zycero/AiPocket-Kicad-ESP32-P4-seconde/AI_Pocket.kicad_pcb

## KiCad design AI_Pocket.kicad_pcb (continued)

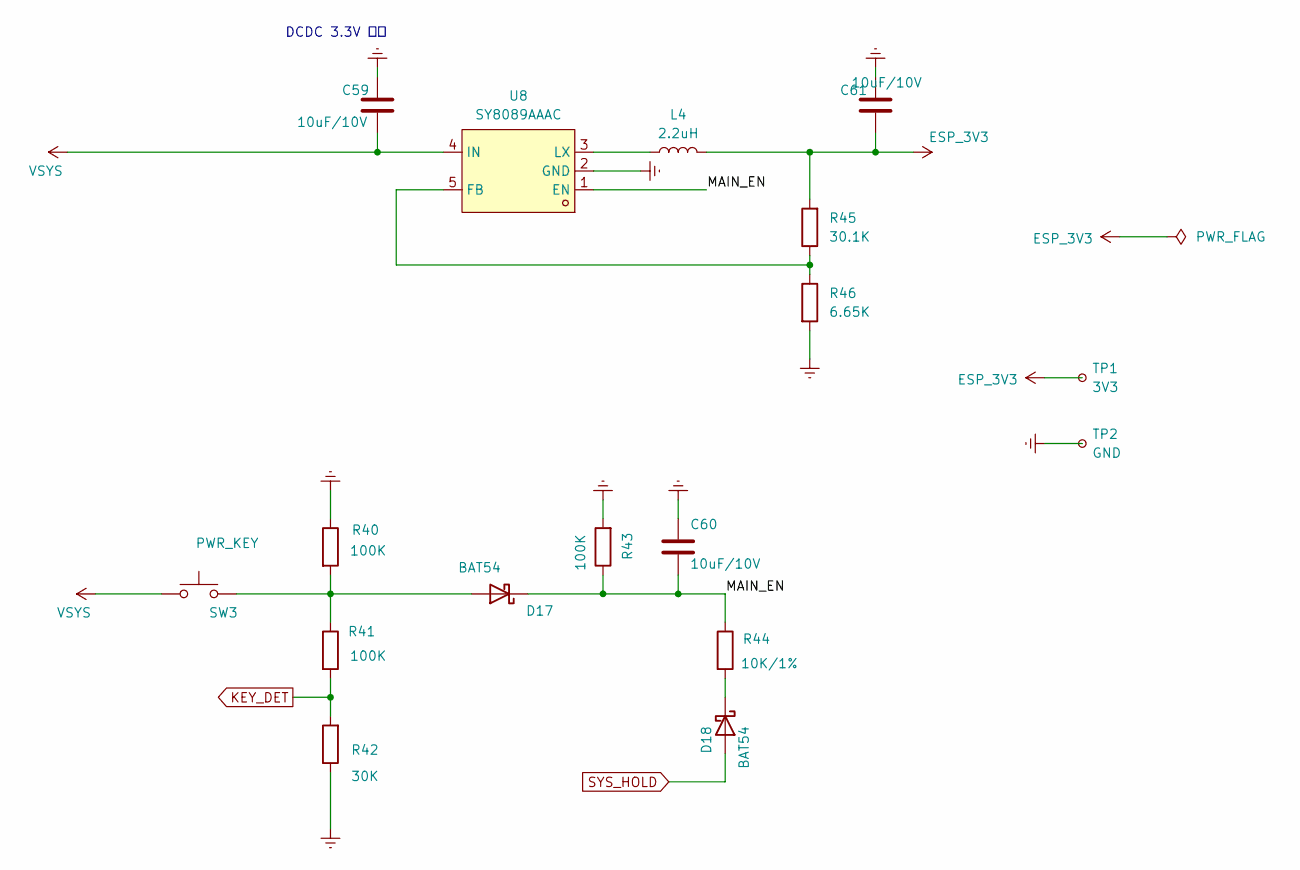
[picture p11: schematic Power_3V3.kicad_sch]

Parts:
C59, C60, C61: 10uF/10V; C_0603_1608Metric; MPN CL10A106KP8NNNC; LCSC C19702
D17, D18: BAT54; D_SOD-123; MPN BAT54T1G; LCSC C152458
L4: 2.2uH; L_1210_3225Metric; MPN FTC322510S2R2MBCA; LCSC C18724399
R40, R41, R43: 100K; R_0402_1005Metric; MPN FRC0402F1003TS; LCSC C2906859
R42: 30K; R_0402_1005Metric; MPN FRC0402F3002TS; LCSC C2909347
R44: 10K/1%; R_0402_1005Metric; MPN AC0402FR-0710KL; LCSC C144807
R45: 30.1K; R_0402_1005Metric; MPN 0402WGF3012TCE; LCSC C25901
R46: 6.65K; R_0402_1005Metric; MPN 0402WGF6651TCE; LCSC C45194
SW3: PWR_KEY; SW-SMD_2P-TS24CA; MPN TS24CA; LCSC C393942
TP1: 3V3; TestPoint_Pad_D1.0mm
TP2: GND; TestPoint_Pad_D1.0mm
U8: SY8089AAAC; SOT-23-5_L3.0-W1.7-P0.95-LS2.8-BR; MPN SY8089AAAC; LCSC C78988

Connections:
/Power/Power_3V3/MAIN_EN: C60.2, D17.1 (K), R43.1, R44.1, U8.1 (EN)
ESP_3V3: C61.1, L4.2, R45.2, TP1.1 (1_1); also elsewhere on the board
GND: C59.2, C60.1, C61.2, R40.1, R42.1, R43.2, R46.2, TP2.1 (1_1), U8.2 (GND); also elsewhere on the board
KEY_DET: R41.2, R42.2; also elsewhere on the board
unnamed: D17.2 (A), R40.2, R41.1, SW3.2
unnamed: D18.1 (K), R44.2
unnamed: R45.1, R46.1, U8.5 (FB)
unnamed: L4.1, U8.3 (LX)
SYS_HOLD: D18.2 (A); also elsewhere on the board
VSYS: C59.1, SW3.1, U8.4 (IN); also elsewhere on the board

Notes on the sheet:
DCDC 3.3V 输出

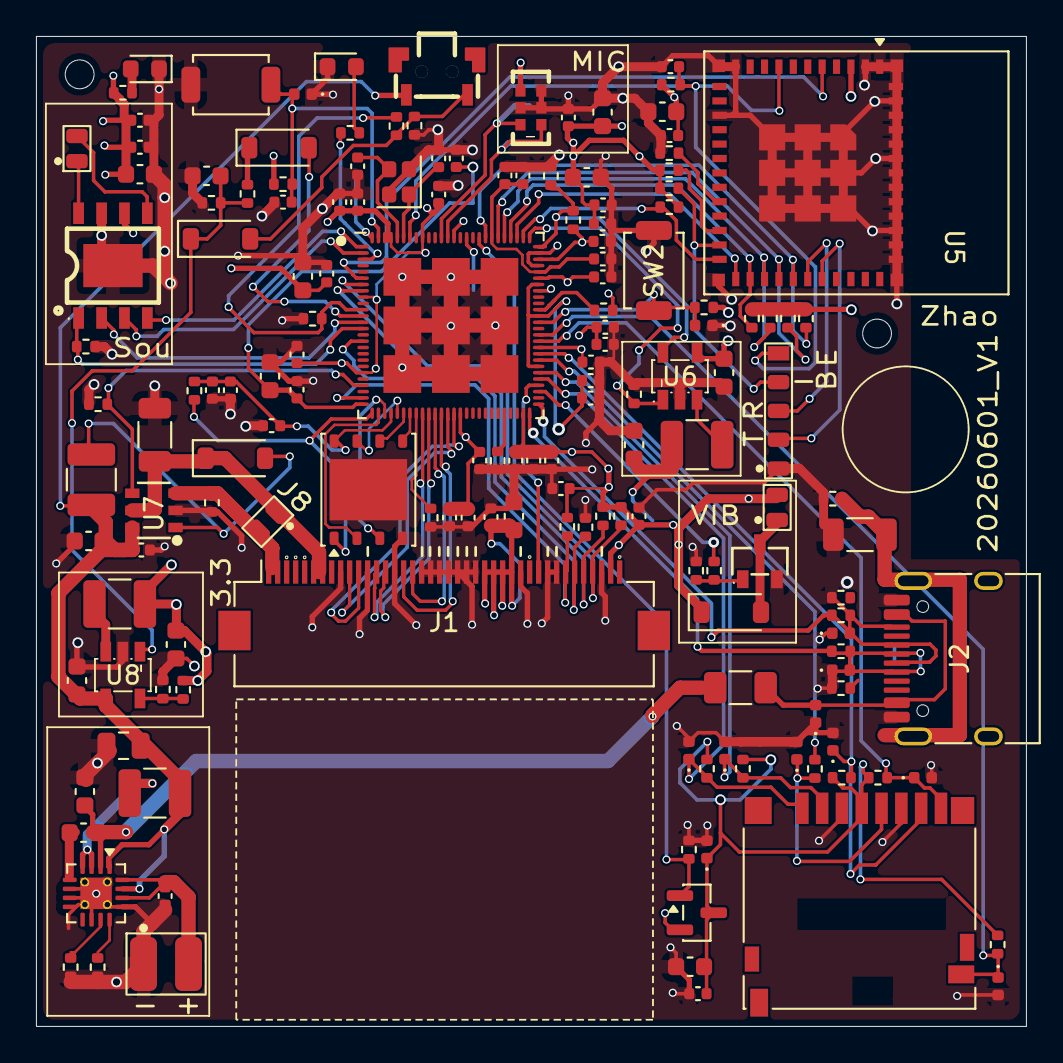
[picture p12: board AI_Pocket.kicad_pcb from above]

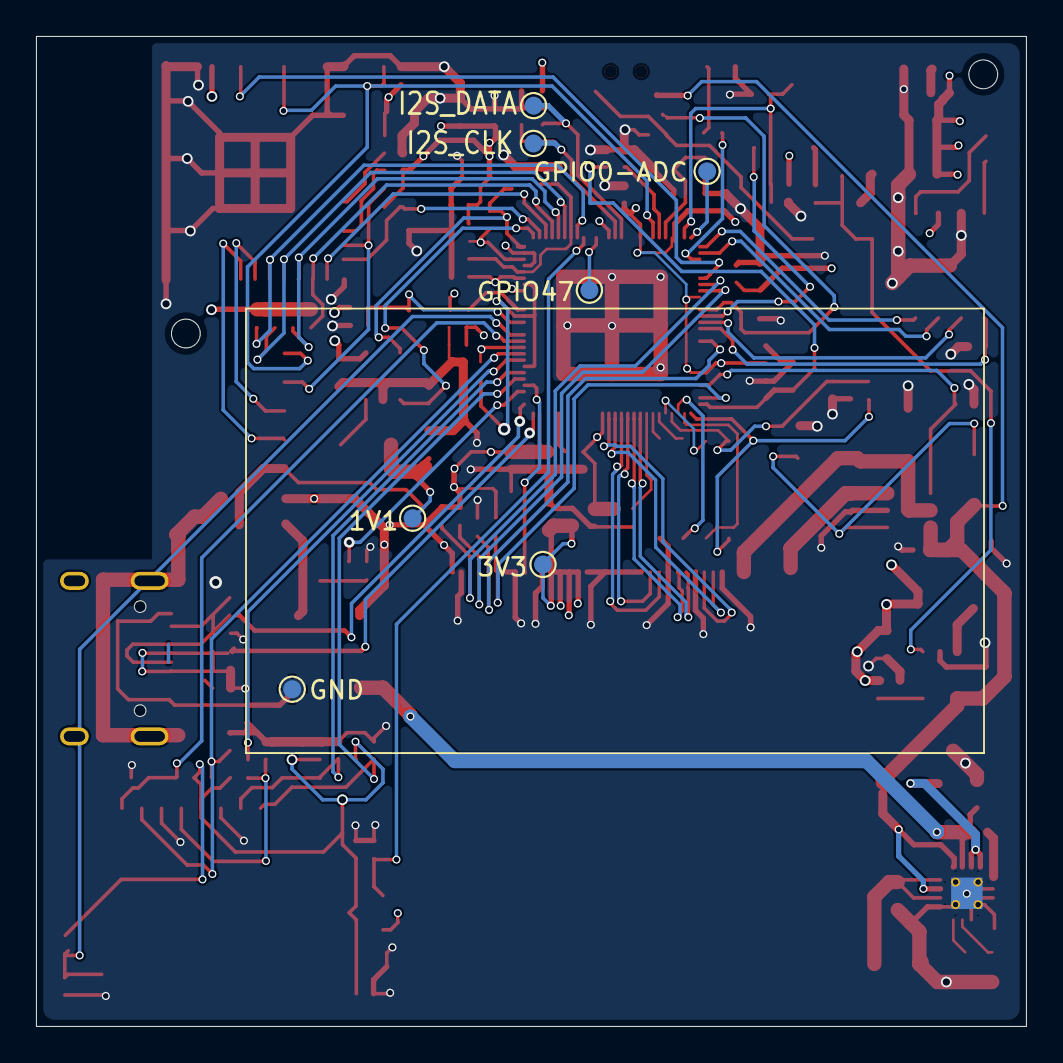
[picture p13: board AI_Pocket.kicad_pcb from below]

Board: 4 copper layers, 55.0 x 55.0 mm, 164 parts (7 on the bottom side), 98 nets.
