zycero/AiPocket-Kicad-ESP32-P4-seconde/(commit log)

2026-09-19 第一次提交
    [AI_Pocket.kicad_pcb, AI_Pocket.kicad_sch, ESP32_C6.kicad_sch, LCD.kicad_sch, LCD_Power.kicad_sch, MIC.kicad_sch, Power.kicad_sch, Power_1V1.kicad_sch]
2026-09-19 删除电阻R9
    [LCD.kicad_sch]
2026-10-09 删除电阻R10
    [LCD.kicad_sch]
2026-10-09 调整LCD_Power连线
    [LCD_Power.kicad_sch]
